AntonKrug/stick-business-card-mk2-blinky/KiCAD/stickMk2-schematic/stickMk2-schematic.kicad_pcb

## KiCad design 65c02-Computer/reset.sch

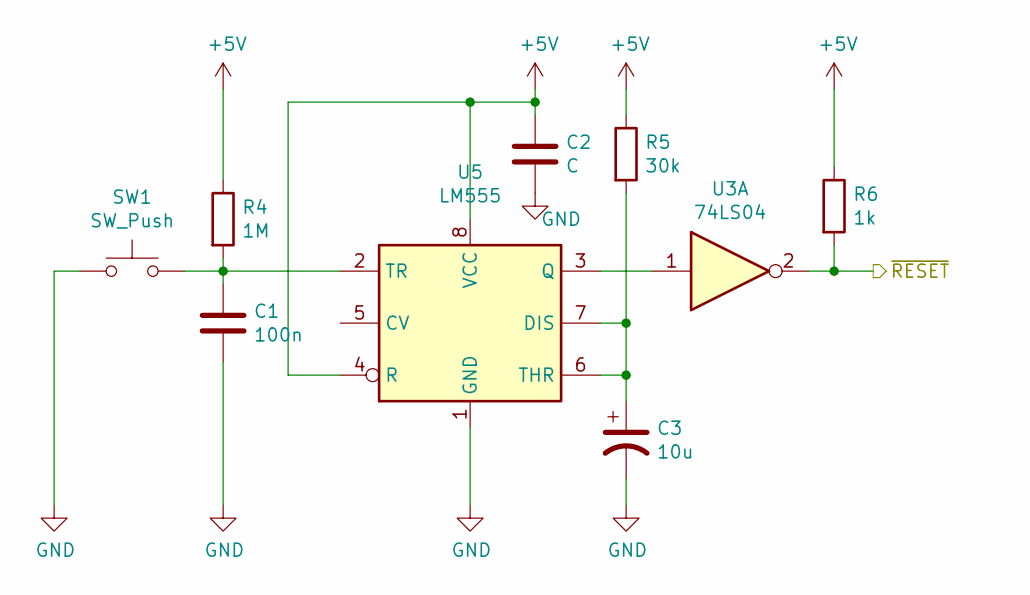
[picture p1: schematic reset.sch]

Parts:
C1: 100n; C_0603_1608Metric
C2: C; C_0603_1608Metric
C3: 10u; CP_Elec_4x3
R4: 1M; R_0603_1608Metric
R5: 30k; R_0603_1608Metric
R6: 1k; R_0603_1608Metric
SW1: SW_Push; SW_SPST_B3S-1000
U3: 74LS04; DIP-14_W7.62mm
U5: LM555; DIP-8_W7.62mm

Connections:
+5V: C2.1, R4.1, R5.1, R6.1, U5.4 (R), U5.8 (VCC)
GND: C1.2, C2.2, C3.2, SW1.1, U5.1 (GND)
unnamed: C1.1, R4.2, SW1.2, U5.2 (TR)
unnamed: C3.1, R5.2, U5.6 (THR), U5.7 (DIS)
unnamed: U3.1, U5.3 (Q)
~RESET: R6.2, U3.2
