AntonKrug/stick-business-card-mk2-blinky/(commit log)

2021-07-15 Can't see USB connector
2021-07-15 Board and ISP pinouts
2021-07-18 Moved ISP pinout
    [stickMk2-isp.kicad_pcb, stickMk2-isp.sch]
2021-07-20 Blinky sources added
    [bc_mk2_v1.cfg]
2021-07-20 Moving src to src_blinky
    [bc_mk2_v1.cfg]
2021-07-21 Adding PCB image references
2021-07-21 Ignore schematic backups
2021-07-21 Schematics added
2021-07-21 KiCAD files in correct folder
    [stickMk2-schematic.kicad_pcb, stickMk2-schematic.sch]
2021-07-21 Added XTAL reference
    [stickMk2-schematic.sch]
2021-08-08 Moving KiCAD section and tweaking headers
2021-08-08 Specifying the pull-up resistor
2021-08-08 Do not change direction of the LED's port before changing its value first
